albymor/XS3868-Shield/Printing Print.pdf

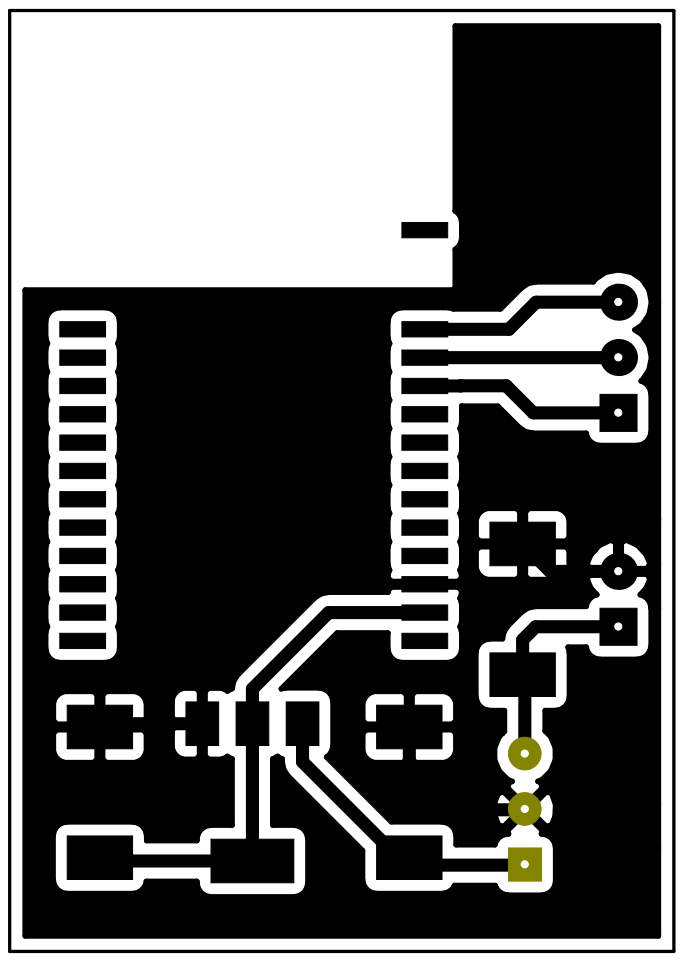
[picture p1: page 1]
