albymor/XS3868-Shield/Documentazione/Electronics Schematic Rev0.pdf

# BLUETOOTH MODULE

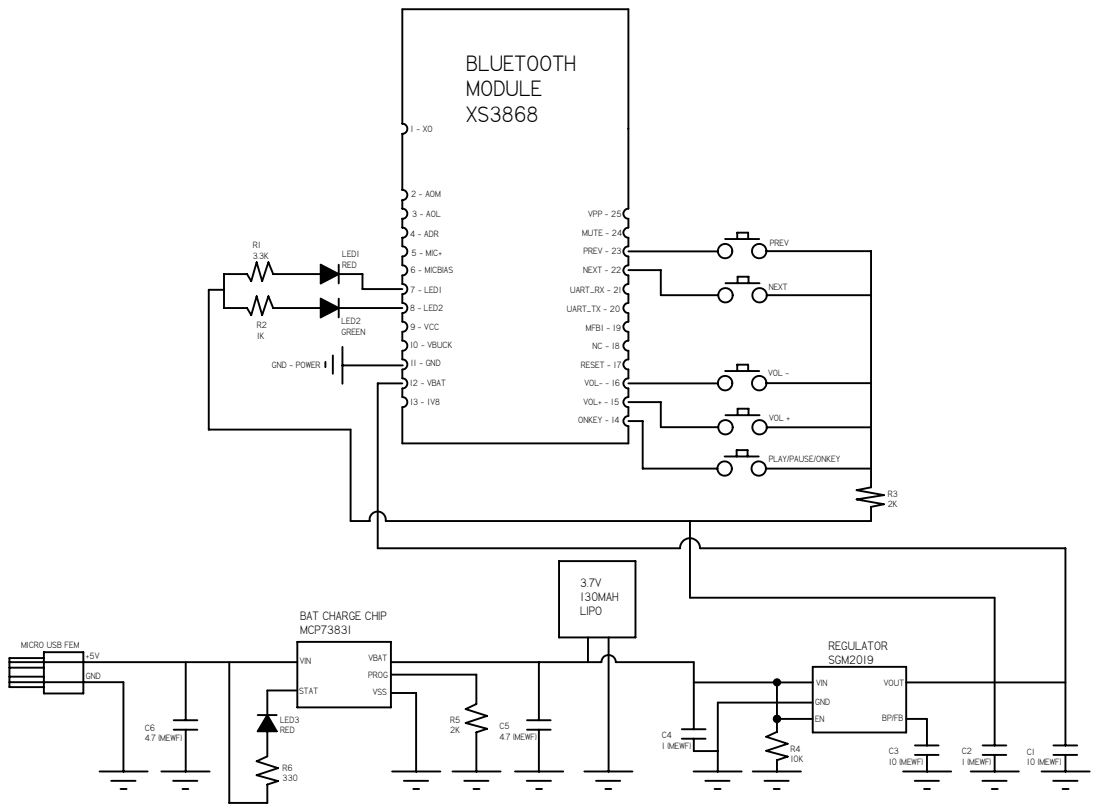
[picture p2: page 1]
