albymor/XS3868-Shield/XS3868-Shield.kicad_pcb

## KiCad design XS3868-Shield.kicad_pcb (2017-03-10)

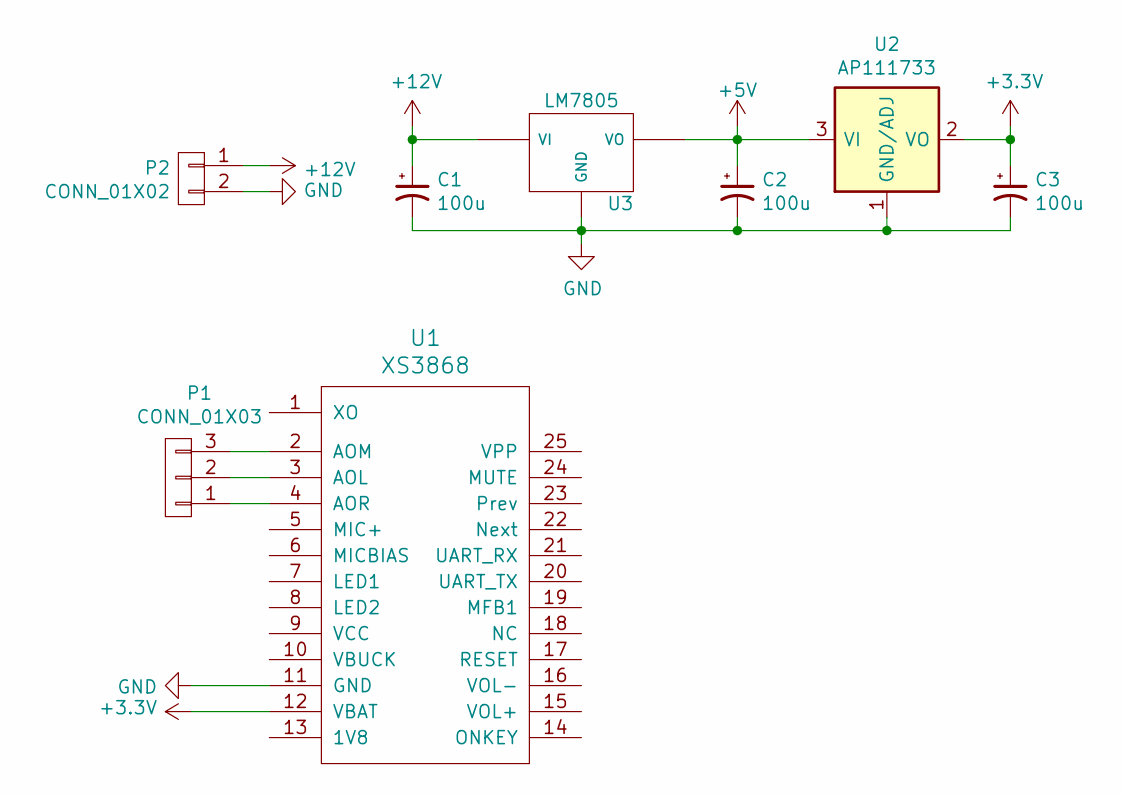
[picture p3: schematic XS3868-Shield.sch]

Parts:
C1, C2, C3: 100u; SMD-2512_Pol
P1: CONN_01X03; Pin_Header_Straight_1x03_Pitch2.54mm
P2: CONN_01X02; Pin_Header_Straight_1x02_Pitch2.54mm
U1: XS3868; XS3868_Module
U2: AP111733; SOT-223
U3: LM7805; LM7805_TO92

Connections:
+3V3: C3.1, U1.12 (VBAT), U2.2 (VO), U2.4 (VO)
+5V: C2.1, U2.3 (VI), U3.VO
+12V: C1.1, P2.1, U3.VI
GND: C1.2, C2.2, C3.2, P2.2, U1.11 (GND), U2.1 (GND/ADJ), U3.GND
unnamed: P1.1, U1.4 (AOR)
unnamed: P1.2, U1.3 (AOL)
unnamed: P1.3, U1.2 (AOM)

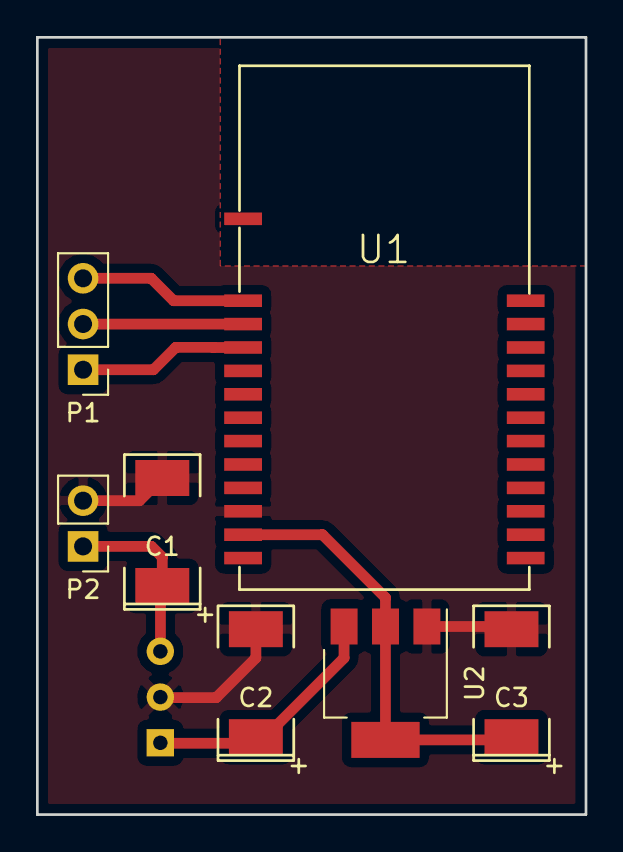
[picture p4: board XS3868-Shield.kicad_pcb from above]

Board: 2 copper layers, 30.5 x 43.2 mm, 8 parts (1 on the bottom side), 7 nets.
