albymor/XS3868-Shield/(commit log)

2017-02-23 PCB done
    [XS3868-Shield.kicad_pcb]
2017-03-10 Added ground plane
    [XS3868-Shield.kicad_pcb, XS3868-Shield.sch]
2017-03-10 Layout review
    [XS3868-Shield.kicad_pcb, XS3868-Shield.sch]
